agurlask/chipathon-2026-gf180mcu-hall-effect-sensor/docs/schematic_review/schematic_review.tex

\documentclass{article}

\usepackage[T1]{fontenc}
\usepackage{cite}
\usepackage{graphicx} 
\usepackage{caption}    
\usepackage{subcaption} 
\usepackage{booktabs}
\usepackage{array}
\usepackage{siunitx}
\usepackage{float}
\usepackage{tabularx}
\usepackage{indentfirst}
\usepackage{xcolor}
\usepackage{url}
\usepackage{amssymb}

\renewcommand{\arraystretch}{1.2}
\setlength{\tabcolsep}{6pt}

\title{Capacitively-Coupled Chopper Instrumentation Amplifier for Linear Hall Effect Sensor \\[1ex] \large IEEE SSCS Chipathon 2026}
\author{Team Chop}
\date{\today}

\begin{document}

\maketitle

\newpage

\tableofcontents

\newpage

\section{Project Information}

\begin{center}
\begin{tabular}{|c c|} 
 \hline
 Project Name & CCIA for Linear Hall Effect Sensor \\
 \hline
 Team Members & alang \\ 
 \hline
 Review Date &  \\
 \hline
 Review Version &  \\
 \hline
 Track & B \\
 \hline
\end{tabular}
\end{center}

\newpage

\section{Design Objective}

The aim of this project is to design and characterize a monolithic magnetic sensing system based on the Hall Effect. 
If tapeout is completed, the specifications of the sensor and readout circuit will be characterized individually.

The target specifications for the magnetic sensing system are shown in Table~\ref{tab:system_specs}. 
These are currently guess-timated based on what has been achieved in the literature 
and are subject to change.

\begin{table}[H]
    \centering
    \begin{tabular}{|c c|}
        \hline
        \textbf{Specification} & \textbf{Value} \\
        \hline
        Maximum Offset & \SI{100}{\micro\tesla} \\
        \hline
        Area & \SI{0.25}{\milli\meter\squared} \\
        \hline
        Resolution & \SI{100}{\micro\tesla}\textsubscript{rms} \\
        \hline
        Input Range & \SI{50}{\milli\tesla}\textsubscript{rms} \\
        \hline
        Bandwidth & \SI{10}{\kilo\hertz} \\
        \hline
        Supply Voltage ($V_{DD}$) & \SI{3.3}{\volt} \\
        \hline
        Maximum Supply Current & \SI{2}{\milli\ampere} \\
        \hline
        Operating Temperature & \SI{25}{\degreeCelsius} \\
        \hline
        Chopping Frequency & \SI{100}{\kilo\hertz} \\
        \hline
        Nominal Output Common-Mode Voltage & $V_{DD}$/2 \\
        \hline
    \end{tabular}
    \caption{System Specifications}
    \label{tab:system_specs}
\end{table}

The motivation for this project in the context of the Chipathon program is to provide reusable IP to the open-source silicon community.
Priority will be given to designing a simple system that can be well characterized as opposed to a novel system.
Overall, if the tapeout is successful, future designers would be able to reuse and customize both the sensor design and
the readout circuit for their specific application. In any case, future Chipathon participants will be able to learn from the 
successes and failures of the project. 

\newpage

\section{System Overview}

A block diagram of the system is shown in Fig.~\ref{fig:block_diagram}. 

\begin{figure}[htbp]
    \centering
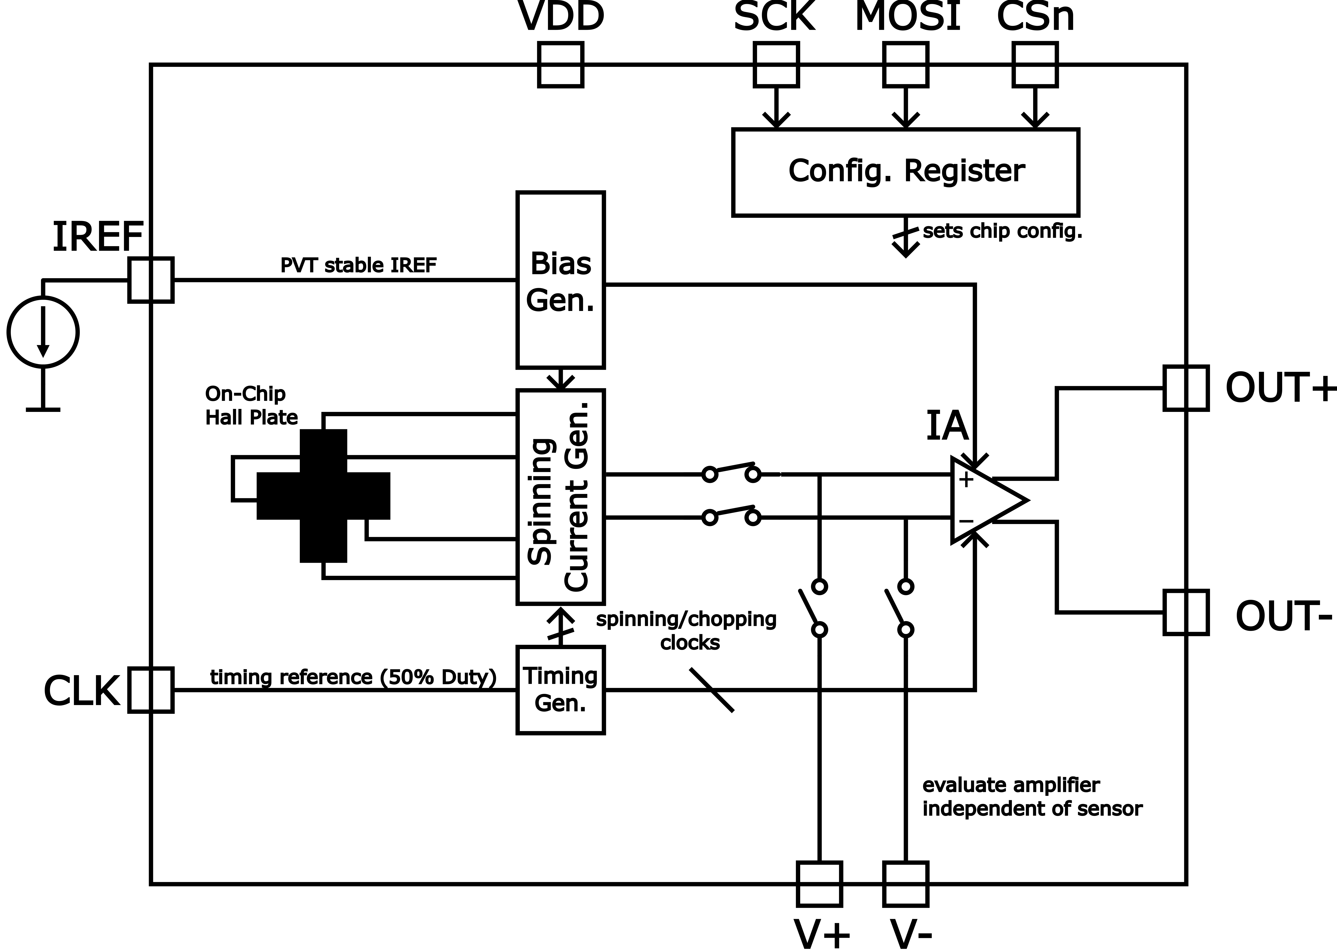
[picture p1: docs/schematic_review/figs/chip_block_diagram.png]
    
    \caption{Block diagram of the proposed architecture.}
    \label{fig:block_diagram}
\end{figure}

In the diagram, an on-chip horizontal Hall plate converts an incoming magnetic
field (perpendicular to plane of chip) into a small voltage that is amplified by the instrumentation amplifier (IA)
prior to being driven to the DUT output pins (OUT+/OUT-). The entire design operates from 
a single supply. Aside from the SPI configuration interface (only used during idle periods), 
the entire design operates in a single synchronous clock domain derived from the external clock signal (CLK).
Two additional pins are used as analog debug pins (V+/V-). Based on the system configuration, these pins will used
to probe various points within the design to enable individual characterization of the sensor and IA.

A full pinout table of the design is given in Table~\ref{tab:pinout}.

\begin{table}[H]
    \centering
    \begin{tabularx}{\linewidth}{l l X}
        \toprule

        \multicolumn{3}{l}{\textbf{Analog Pins}} \\
        \midrule
        IREF   & Analog & Current reference \\
        OUT+   & Analog & (+) Output \\
        OUT-   & Analog & (-) Output \\
        VTP+   & Analog & (+) Test Point \\
        VTP-   & Analog & (-) Test Point \\
        \midrule

        \multicolumn{3}{l}{\textbf{Digital Pins}} \\
        \midrule
        SCK    & Digital Input & SPI configuration clock \\
        MOSI   & Digital Input & SPI configuration data input \\
        CSn    & Digital Input & SPI chip select \\
        CLK    & Digital Input & Chopping/spinning clock reference \\
        \midrule

        \multicolumn{3}{l}{\textbf{Supply Pins}} \\
        \midrule
        VDD    & Power & Supply input \\
        VSS    & Power & Ground (shared with other Chipathon blocks) \\
        \bottomrule
    \end{tabularx}
    \caption{Project I/O description.}
    \label{tab:pinout}
\end{table}

\newpage

\section{Schematic Summary}

\textbf{Note:} Only open \path{xschem} from the \path{xschem/} directory 
(i.e., \path{cd} to \path{xschem/} and then run \path{xschem} \path{/path/to/schematic} to open any schematics).

This section describes the schematic-level operation of each part of the design. For each block, 
both behavioral and transistor-level models are described, including motivation for key design 
decisions. For all blocks, the transistor-level sizing is subject to change during the verification
process.

A more detailed block diagram of the top level schematic is shown in Fig.~\ref{fig:top_level_bhv}, using 
the signal names used throughout the Xschem schematic design. The sub-sections below describe the detailed operation
of each block.

\begin{figure}[htbp]
    \centering
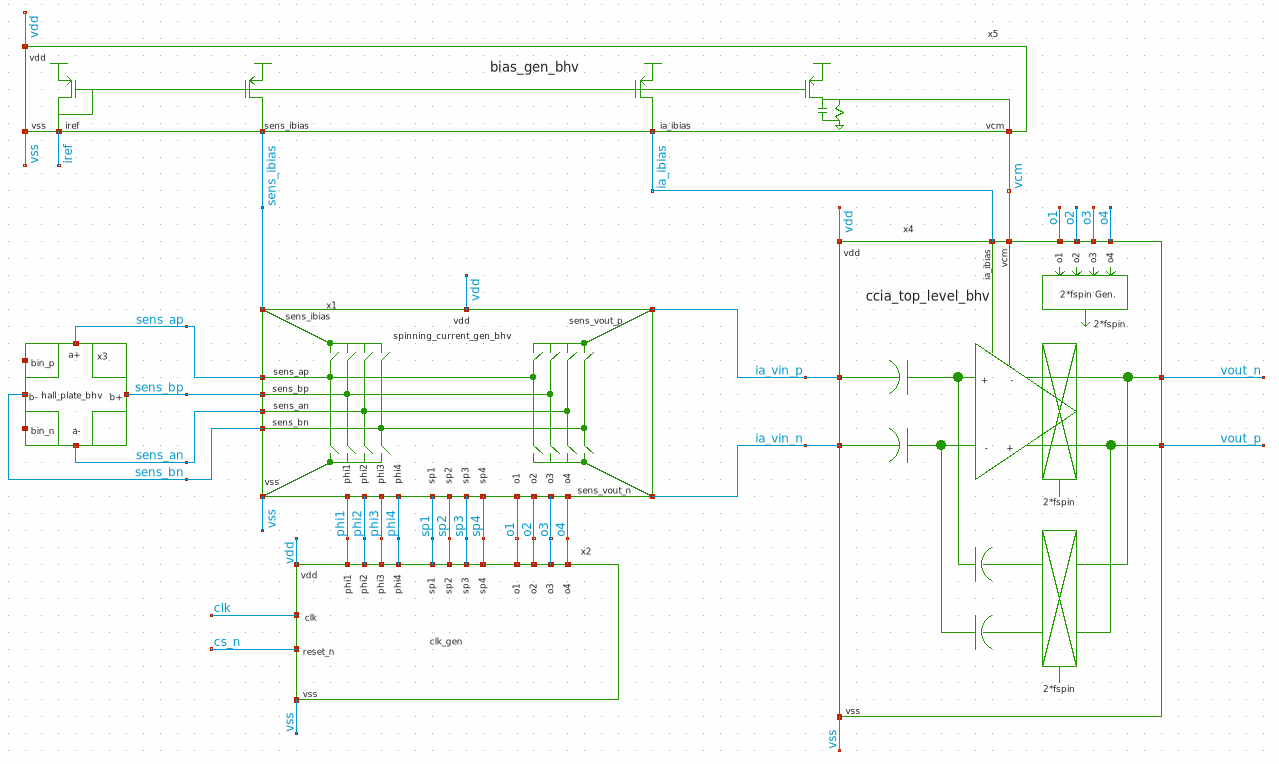
[picture p2: docs/schematic_review/figs/top_level_bhv.png]
    
    \caption{
        More detailed block diagram of top level schematic, showing the detailed connection 
        between all blocks, excluding the SPI configuration interface. 
        The Hall plate (left) is connected to the spinning current generator (center),
        which periodically swaps the bias/readout terminals of the sensor prior to
        amplification and demodulation by the instrumentation amplifier (right). The internal 
        clocks are generated by the clock generator block (bottom) and all bias currents
        are derived from an external reference in the bias generator block (top).
    }
    \label{fig:top_level_bhv}
\end{figure}

\subsection{On-Chip Hall Plate}

\subsubsection*{Purpose}

The on-chip Hall plate is a four-terminal device. Throughout the design,
the naming convention given in \cite{Mosser2017SpinningCurrent} is used to refer to the four terminal device. The orientation
of the four pins, (a+, b+, a-, b-), is shown in Fig.~\ref{fig:hall_plate_bhv}. As hinted
in the schematic symbol, a cross-shaped plate geometry is used to enable
four-phase spinning current operation, described in Section~\ref{subsec:spinning_current_generation}.

\begin{figure}[htbp]
    \centering
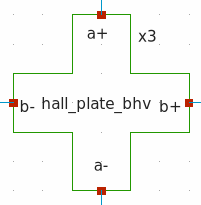
[picture p3: docs/schematic_review/figs/hall_plate_bhv.png]
    
    \caption{
        Xschem schematic symbol for on-chip Hall plate, showing (a+, b+, a-, b-) pin
        orientation and naming convention.
    }
    \label{fig:hall_plate_bhv}
\end{figure}

\subsubsection*{Inputs and Outputs}

As discussed in the previous section, the Hall plate has only four terminals since the
bias and readout is performed in a higher-level block.

INSERT I/O TABLE

\subsubsection*{Sub-sheets}

\begin{itemize}
    \item{Behavioral: \path{xschem/hall_plate_bhv/hall_plate_bhv.sch}}
    \item{Implementation: \textcolor{red}{$\times$}}
\end{itemize}

\subsubsection*{Behavioral Model}

The plan for sensor behavioral modeling is to use the basic model linear model 
described in \cite{Xu2011ImprovedEquivalent}. Clearly, the symbol shown in Fig.~\ref{fig:hall_plate_bhv} needs an
additional input to provide the incoming magnetic field.

\subsubsection*{Design Methodology}

\begin{itemize}
    \item{n-well used to maximize sensitivity}
    \item{
        Design equations in \cite{Xu2011ImprovedEquivalent} used to estimate bridge resistor values 
        in behavioral model from n-well sheet resistance, n-well electron mobility, and geometry
    }
    \begin{itemize}
        \item{
            Sensor geometry target currently 75x75 um (from \cite{Xu2011ImprovedEquivalent}, L=25 um and W=25 um).
            Final decision will depend on (1) min contact size/DRC limitations, (2) parasitic capacitance, 
            (3) thermal considerations at maximum bias current.
        }
        \item{n-well electron mobility estimated to make sensor have raw sensitivity of $\SI{100}{\volt\per(\ampere\cdot\tesla)}$}
    \end{itemize}
\end{itemize}

\subsubsection*{Transistor-Level Implementation}

The final schematic for Hall-Plate will simply have pins for the four terminals for
DRC/LVS purposes. All verification will be performed with the behavioral model so that 
the effect of an external magnetic field can be simulated.

\subsection{Bias Generation}

\subsubsection*{Purpose}

The purpose of the bias generation block is to produce the bias currents and voltages needed
by each block from an off-chip reference current. A conceptual schematic of the bias generation block
is shown in Fig.~\ref{fig:bias_gen_bhv}.

\begin{figure}[htbp]
    \centering
    
    \caption{
        Xschem schematic symbol for bias generation block.
        The block creates the sensor bias current and IA current reference from
        an off-chip reference current source. Also, the IA common-mode voltage is generated 
        by an on-chip R-C (buffer may be added if load large enough).  
    }
    \label{fig:bias_gen_bhv}
\end{figure}

\subsubsection*{Inputs and Outputs}

INSERT I/O TABLE

\subsubsection*{Sub-sheets}

\begin{itemize}
    \item{Behavioral: \textcolor{red}{$\times$}}
    \item{Implementation: \textcolor{red}{$\times$}}
\end{itemize}

\subsubsection*{Behavioral Model}

Due to the relative simplicity of the design and issues with ideal current sources
with zero load (large voltage spikes), no behavioral modeling will be done for this block.

\subsubsection*{Design Methodology}

As hinted in the schematic symbol, current mirrors will be used to produce
the bias currents. Transistor dimensions will be chosen to minimize short-channel
effects and current mismatch.

The common-mode voltage generator will be evaluated initially to do the required I-V conversion.

\subsubsection*{Transistor-Level Implementation}

Not started: \textcolor{red}{$\times$}

\subsection{Spinning Current Generation}
\label{subsec:spinning_current_generation}

\subsubsection*{Purpose}

The purpose of the spinning current generation block is to periodically switch the roles
of the four sensor terminals between BIAS+, BIAS-, SENSE+, and SENSE-. The switching sequence is chosen to separate the hall voltage from
the sensor offset and 1/f noise (the hall voltage is modulated to high frequency while the offset and 1/f noise
remains at DC). This allows the sensor offset and 1/f noise to be largely removed from the hall voltage 
in later processing stages. 

A conceptual schematic diagram of the spinning current generation block is shown 
in Fig.~\ref{fig:spinning_current_gen_bhv}. The naming convention for spinning clocks
is stolen from \cite{Jiang2019CMOSWideBandwidth}, where \textit{sp(x)} clocks show the active phase, 
\textit{phi(x)} clocks are used to connect the sensor bias currents to the BIAS terminals,
and \textit{o(x)} clocks are used to connect the SENSE terminals to the IA input.
Separate clocks are used to connect the BIAS and SENSE terminals to avoid adding additional 
spikes to the IA input from the bias current switching 
(time is given for the SENSE voltage to settle prior to connection to the IA). 

\begin{figure}[htbp]
    \centering
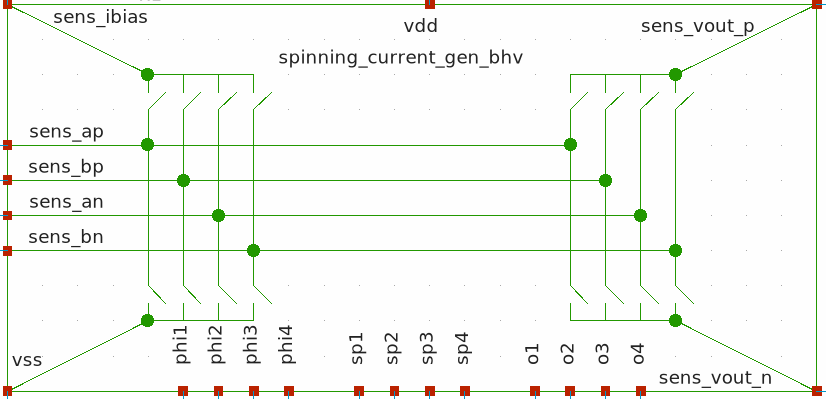
[picture p4: docs/schematic_review/figs/spinning_current_gen_bhv.png]
    
    \caption{
        Xschem schematic symbol for spinning current generation block.
    }
    \label{fig:spinning_current_gen_bhv}
\end{figure}

\subsubsection*{Inputs and Outputs}

INSERT I/O TABLE

\subsubsection*{Sub-sheets}

\begin{itemize}
    \item{Behavioral: \path{xschem/spinning_current_gen_bhv/spinning_current_gen_bhv.sch}}
    \item{Implementation: \textcolor{red}{$\times$}}
\end{itemize}

\subsubsection*{Behavioral Model}

Ideal switches will be used to implement the eight switches needed to connect
the sensor to the IA.

\subsubsection*{Design Methodology}

Transmission gates will be used to implement the SENSE and BIAS switches.
Consideration will be given to both on-resistance and charge injection (ADD REF).

\subsubsection*{Transistor-Level Implementation}

Not started: \textcolor{red}{$\times$}

\subsection{Timing Signal Generation}

\subsubsection*{Purpose}

The purpose of the timing signal generation block is to produce the \textit{sp(x)}, 
\textit{phi(x)}, and \textit{o(x)} clocks from an external clock. Descriptions of the 
three clock signals are given in Section~\ref{subsec:spinning_current_generation}.
The external interface of the timing signal generation block is shown in Fig.~\ref{fig:clk_gen_bhv} 

\begin{figure}[htbp]
    \centering
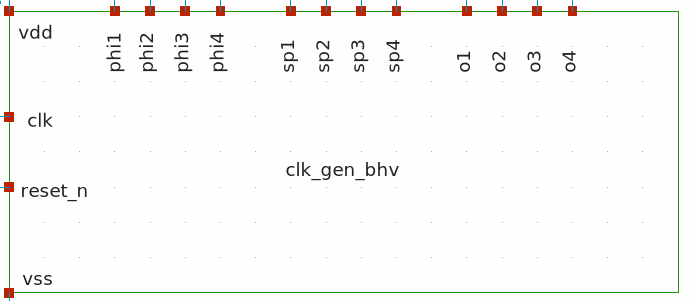
[picture p5: docs/schematic_review/figs/clk_gen_bhv.png]
    
    \caption{
        Xschem schematic symbol for timing signal generation block.
    }
    \label{fig:clk_gen_bhv}
\end{figure}

\subsubsection*{Inputs and Outputs}

INSERT I/O TABLE

\subsubsection*{Sub-sheets}

\begin{itemize}
    \item{Behavioral: \textcolor{red}{$\times$} (see below)}
    \item{Implementation: \path{xschem/clk_gen/clk_gen.sch}}
\end{itemize}

\subsubsection*{Behavioral Model}

Standard cells are directly used to implement the clock generation 
logic. If this slows down simulation significantly, time will be invested to 
use the ngspice XSPICE primitives to implement the required digital circuit in 
an event-driven paradigm. Since I could not find symbols for the GF180MCU 7T standard cells,
custom symbols were created (\path{xschem/mcu7t5v0/})

\subsubsection*{Design Methodology}

The clock generation circuits from Chapter 3 of \cite{Jiang2019CMOSWideBandwidth} will be used. 

\subsubsection*{Transistor-Level Implementation}

Completed: \textcolor{green}{\checkmark}

\subsection{Configuration Register}

The configuration register will be a N-bit shift register, allowing for the dynamic
configuration of the test chip. Some ideas of configuration options are: (1) variable sensor
bias current, (2) preamplifier voltage input (i.e., disconnect sensor and supply IA input externally),
(3) sensor debug (i.e., connect hall plate terminals to external pins for debug). 
Once more of the implementation is completed, these configuration options will be revisited.

\subsection{Instrumentation Amplifier}

The IA will use a CCIA structure very similar to the one reported in \cite{Zou2023CMOSHallArray}.

\begin{itemize}
    \item{Purpose}
    \item{Inputs and Outputs}
    \item{Sub-sheets}
    \item{Behavioral Model}
    \item{Design Methodology}
    \item{Transistor-Level Implementation}
\end{itemize}

\newpage

\section{Design Assumptions}

The following assumptions are made within the design.

\begin{itemize}
    \item{The circuit shall be designed to operate from a single 3.3V supply}
    \item{The circuit shall be designed to operate over the temperature range of (\SI{-40}{\degreeCelsius} - \SI{125}{\degreeCelsius}). 
    Accurately modeling the sensor over this temperature range is out of scope, so system specifications are only given at room temperature.}
    \item{The specifications of each circuit shall be simulated over all worst-case process corners}
    \item{Each analog output (both OUT+ and OUT-) of the 
    readout circuit shall be capable of driving a 
    10 pF off-chip load (representative of commericially available 
    CMOS op amps).}
    \item{
    To test the full system, an external magnetic 
    field will be applied via a Helmholtz coil pair. 
    A printed circuit board will be designed to supply 
    all DUT inputs and condition the differential 
    readout circuit output prior to digitization.
    }
\end{itemize}

\newpage

\section{Verification Status}

\subsection{Functional Simulations}

\subsubsection*{Basic Spinning Current Verification}

The purpose of this testbench is to verify the sensor behavioral model and spinning current generation
appropriately reduce the sensor offset using ideal IA and chopping switches. 

See \path{/xschem/spin_test/spin_test.sch}

\subsection{Corner Simulations}

Not started

\subsection{Monte Carlo}

Not started

\subsection{Sign-off}

\begin{itemize}
    \item{ERC Status \textcolor{red}{$\times$}}
    \item{DRC Status \textcolor{red}{$\times$}}
    \item{LVS Status \textcolor{red}{$\times$}}
\end{itemize}

\newpage

\section{Design Checklist}

\subsection{Functionality}

\begin{itemize}
    \item{Requirements implemented \textcolor{red}{$\times$}}
    \item{Reset behavior verified \textcolor{red}{$\times$}}
    \item{Startup verified \textcolor{red}{$\times$}}
    \item{Power sequencing considered \textcolor{red}{$\times$}}
\end{itemize}

\subsection{Analog}

\begin{itemize}
    \item{Bias currents checked \textcolor{red}{$\times$}}
    \item{Device operating regions verified \textcolor{red}{$\times$}}
    \item{Stability analyzed \textcolor{red}{$\times$}}
    \item{Noise considered \textcolor{red}{$\times$}}
    \item{Matching requirements identified \textcolor{red}{$\times$}}
\end{itemize}

\subsection{Digital}

N/A

\subsection{Mixed-Signal}

N/A

\subsection{Reliability}

\begin{itemize}
    \item{Device voltage limits checked \textcolor{red}{$\times$}}
    \item{Current density reviewed \textcolor{red}{$\times$}}
    \item{Latch-up prevention considered \textcolor{red}{$\times$}}
    \item{ESD strategy identified \textcolor{red}{$\times$}}
\end{itemize}

\subsection{Documentation}

\begin{itemize}
    \item{Nets clearly named \textcolor{red}{$\times$}}
    \item{Hierarchy consistent \textcolor{red}{$\times$}}
    \item{Parameters documented \textcolor{red}{$\times$}}
    \item{Symbols match implementation \textcolor{red}{$\times$}}
\end{itemize}

\newpage

\section{Open Issues}

List of open issues with:

\begin{itemize}
    \item{Description}
    \item{Impact}
    \item{Proposed Solution}
    \item{Owner}
\end{itemize}

\newpage

\section{Questions for Reviewers}

\newpage

\section{Review Outcome}

\newpage

\section{Appendix}

\newpage

\cleardoublepage
\addcontentsline{toc}{section}{References}
\bibliographystyle{IEEEtran}
\bibliography{references}

\end{document}
