agurlask/chipathon-2026-gf180mcu-hall-effect-sensor/docs/schematic_review/schematic_review.pdf

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

## 2 Design Objective

The aim of this project is to design and characterize a monolithic magnetic sensing system based on the Hall Eect. If tapeout is completed, the specications of the sensor and readout circuit will be characterized individually.
The target specications for the magnetic sensing system are shown in Table 1. These are currently guess-timated based on what has been achieved in the literature and are subject to change.
Specication | Value
Maximum Oset | 100 µT
Area | 0.25 mm²
Resolution | 100 µTrms
Input Range | 50 mTrms
Bandwidth | 10 kHz
Supply Voltage (VDD) | 3.3 V
Maximum Supply Current | 2 mA
Operating Temperature | 25 ◦C
Chopping Frequency | 100 kHz
Nominal Output Common-Mode Voltage | VDD/2

Table 1: System Specications

The motivation for this project in the context of the Chipathon program is to provide reusable IP to the open-source silicon community. Priority will be given to designing a simple system that can be well characterized as opposed to a novel system. Overall, if the tapeout is successful, future designers would be able to reuse and customize both the sensor design and the readout circuit for their specic application. In any case, future Chipathon participants will be able to learn from the successes and failures of the project.

4

3 | System Overview
| A block diagram of the system is shown in Fig. 1.


Figure 1: Block diagram of the proposed architecture.

In the diagram, an on-chip horizontal Hall plate converts an incoming magnetic eld (perpendicular to plane of chip) into a small voltage that is amplied by the instrumentation amplier (IA) prior to being driven to the DUT output pins (OUT+/OUT-). The entire design operates from a single supply. Aside from the SPI conguration interface (only used during idle periods), the entire design operates in a single synchronous clock domain derived from the external clock signal (CLK). Two additional pins are used as analog debug pins (V+/V-). Based on the system conguration, these pins will used to probe various points within the design to enable individual characterization of the sensor and IA. A full pinout table of the design is given in Table 2.

5

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

4 | Schematic Summary
| Note: Only open xschem from the xschem/ directory (i.e., cd to xschem/
and then run xschem /path/to/schematic to open any schematics).
| This section describes the schematic-level operation of each part of the de-
sign. For each block, both behavioral and transistor-level models are described, including motivation for key design decisions. For all blocks, the transistor-level sizing is subject to change during the verication process.
| A more detailed block diagram of the top level schematic is shown in Fig. 2,
using the signal names used throughout the Xschem schematic design. The sub-sections below describe the detailed operation of each block.


Figure 2: More detailed block diagram of top level schematic, showing the detailed connection between all blocks, excluding the SPI conguration interface. The Hall plate (left) is connected to the spinning current generator (center), which periodically swaps the bias/readout terminals of the sensor prior to amplication and demodulation by the instrumentation amplier (right). The internal clocks are generated by the clock generator block (bottom) and all bias currents are derived from an external reference in the bias generator block (top).

4.1 On-Chip Hall Plate

Purpose

The on-chip Hall plate is a four-terminal device. Throughout the design, the naming convention given in [1] is used to refer to the four terminal device. The orientation of the four pins, (a+, b+, a-, b-), is shown in Fig. 3. As hinted in the

7

schematic symbol, a cross-shaped plate geometry is used to enable four-phase spinning current operation, described in Section 4.3.

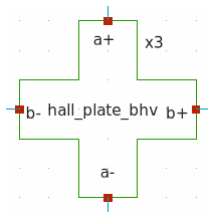
[picture p7: figure]

Figure 3: Xschem schematic symbol for on-chip Hall plate, showing (a+, b+, a-, b-) pin orientation and naming convention.

Inputs and Outputs

As discussed in the previous section, the Hall plate has only four terminals since the bias and readout is performed in a higher-level block.
INSERT I/O TABLE

Sub-sheets

Behavioral: xschem/hall_plate_bhv/hall_plate_bhv.sch

Implementation: ×

Behavioral Model

The plan for sensor behavioral modeling is to use the basic model linear model described in [2]. Clearly, the symbol shown in Fig. 3 needs an additional input to provide the incoming magnetic eld.

Design Methodology

n-well used to maximize sensitivity

Design equations in [2] used to estimate bridge resistor values in behavioral model from n-well sheet resistance, n-well electron mobility, and geometry

Sensor geometry target currently 75x75 um (from [2], L=25 um and W=25 um). Final decision will depend on (1) min contact size/DRC limitations, (2) parasitic capacitance, (3) thermal considerations at maximum bias current.
n-well electron mobility estimated to make sensor have raw sensitivity of 100 V/(A · T)

8

Transistor-Level Implementation

The nal schematic for Hall-Plate will simply have pins for the four terminals for DRC/LVS purposes. All verication will be performed with the behavioral model so that the eect of an external magnetic eld can be simulated.

4.2 Bias Generation

Purpose

The purpose of the bias generation block is to produce the bias currents and voltages needed by each block from an o-chip reference current. A conceptual schematic of the bias generation block is shown in Fig. 4.

Figure 4: Xschem schematic symbol for bias generation block. The block creates the sensor bias current and IA current reference from an o-chip reference current source. Also, the IA common-mode voltage is generated by an on-chip R-C (buer may be added if load large enough).

Inputs and Outputs

INSERT I/O TABLE

Sub-sheets

Behavioral: ×

Implementation: ×

Behavioral Model

Due to the relative simplicity of the design and issues with ideal current sources with zero load (large voltage spikes), no behavioral modeling will be done for this block.

Design Methodology

As hinted in the schematic symbol, current mirrors will be used to produce the bias currents. Transistor dimensions will be chosen to minimize shortchannel eects and current mismatch.
The common-mode voltage generator will be evaluated initially to do the required I-V conversion.

9

Transistor-Level Implementation

Not started: ×

4.3 Spinning Current Generation

Purpose

The purpose of the spinning current generation block is to periodically switch the roles of the four sensor terminals between BIAS+, BIAS-, SENSE+, and SENSE-. The switching sequence is chosen to separate the hall voltage from the sensor oset and 1/f noise (the hall voltage is modulated to high frequency while the oset and 1/f noise remains at DC). This allows the sensor oset and 1/f noise to be largely removed from the hall voltage in later processing stages. A conceptual schematic diagram of the spinning current generation block is shown in Fig. 5. The naming convention for spinning clocks is stolen from [3], where sp(x) clocks show the active phase, phi(x) clocks are used to connect the sensor bias currents to the BIAS terminals, and o(x) clocks are used to connect the SENSE terminals to the IA input. Separate clocks are used to connect the BIAS and SENSE terminals to avoid adding additional spikes to the IA input from the bias current switching (time is given for the SENSE voltage to settle prior to connection to the IA).


Figure 5: Xschem schematic symbol for spinning current generation block.

Inputs and Outputs

INSERT I/O TABLE

10

Sub-sheets

Behavioral: xschem/spinning_current_gen_bhv/spinning_current_gen_ bhv.sch

Implementation: ×

Behavioral Model

Ideal switches will be used to implement the eight switches needed to connect the sensor to the IA.

Design Methodology

Transmission gates will be used to implement the SENSE and BIAS switches. Consideration will be given to both on-resistance and charge injection (ADD REF).

Transistor-Level Implementation

Not started: ×

4.4 Timing Signal Generation

Purpose

The purpose of the timing signal generation block is to produce the sp(x), phi(x), and o(x) clocks from an external clock. Descriptions of the three clock signals are given in Section 4.3. The external interface of the timing signal generation block is shown in Fig. 6


Figure 6: Xschem schematic symbol for timing signal generation block.

11

Inputs and Outputs

INSERT I/O TABLE

Sub-sheets

Behavioral: × (see below)

Implementation: xschem/clk_gen/clk_gen.sch

Behavioral Model

Standard cells are directly used to implement the clock generation logic. If this slows down simulation signicantly, time will be invested to use the ngspice XSPICE primitives to implement the required digital circuit in an event-driven paradigm. Since I could not nd symbols for the GF180MCU 7T standard cells, custom symbols were created (xschem/mcu7t5v0/)

Design Methodology

The clock generation circuits from Chapter 3 of [3] will be used.

Transistor-Level Implementation

Completed: ✓

4.5 Conguration Register

The conguration register will be a N-bit shift register, allowing for the dynamic conguration of the test chip. Some ideas of conguration options are:
(1) variable sensor bias current, (2) preamplier voltage input (i.e., disconnect sensor and supply IA input externally), (3) sensor debug (i.e., connect hall plate terminals to external pins for debug). Once more of the implementation is completed, these conguration options will be revisited.

4.6 Instrumentation Amplier

The IA will use a CCIA structure very similar to the one reported in [4].

Purpose

Inputs and Outputs

Sub-sheets

Behavioral Model

Design Methodology

Transistor-Level Implementation

12

5 | Design Assumptions
| The following assumptions are made within the design.
| The circuit shall be designed to operate from a single 3.3V supply The circuit shall be designed to operate over the temperature range of (−40 ◦C - 125 ◦C). Accurately modeling the sensor over this temperature range is out of scope, so system specications are only given at room temperature. The specications of each circuit shall be simulated over all worst-case process corners Each analog output (both OUT+ and OUT-) of the readout circuit shall be capable of driving a 10 pF o-chip load (representative of commericially available CMOS op amps). To test the full system, an external magnetic eld will be applied via a Helmholtz coil pair. A printed circuit board will be designed to supply all DUT inputs and condition the dierential readout circuit output prior to digitization.

13

6 | Verication Status
6.1 | Functional Simulations

Basic Spinning Current Verication

The purpose of this testbench is to verify the sensor behavioral model and spinning current generation appropriately reduce the sensor oset using ideal IA and chopping switches.
See /xschem/spin_test/spin_test.sch

6.2 Corner Simulations

Not started

6.3 Monte Carlo

Not started

6.4 Sign-o

ERC Status ×

DRC Status ×

LVS Status ×

14

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

## References

[1] V. Mosser, N. Matringe, and Y. Haddab, A spinning current circuit for hall measurements down to the nanotesla range, IEEE Transactions on Instrumentation and Measurement, vol. 66, no. 4, pp. 637650, 2017. [Online]. Available: https://ieeexplore.ieee.org/document/7845584
[2] Y. Xu and H.-B. Pan, An improved equivalent simulation model for cmos integrated hall plates, Sensors, vol. 11, no. 6, pp. 62846296, 2011. [Online]. Available: https://www.mdpi.com/1424-8220/11/6/6284
[3] J. Jiang, Cmos wide-bandwidth magnetic sensors for contactless current measurements, Ph.D. dissertation, Delft University of Technology, 2019. [Online]. Available: https://doi.org/10.4233/uuid: 38dfa450-82c2-4b63-92d1-26b2eb3adeed
[4] H. Zou, K.-M. Lei, R. P. Martins, and P.-I. Mak, A cmos hall sensors array with integrated readout circuit resilient to local magnetic interference from current-carrying traces, IEEE Sensors Journal, vol. 23, pp. 16 14516 153, 2023. [Online]. Available: https://ieeexplore.ieee.org/document/10147816

20
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
