agurlask/chipathon-2026-gf180mcu-hall-effect-sensor/xschem/spin_test/diff_avg_plot.png

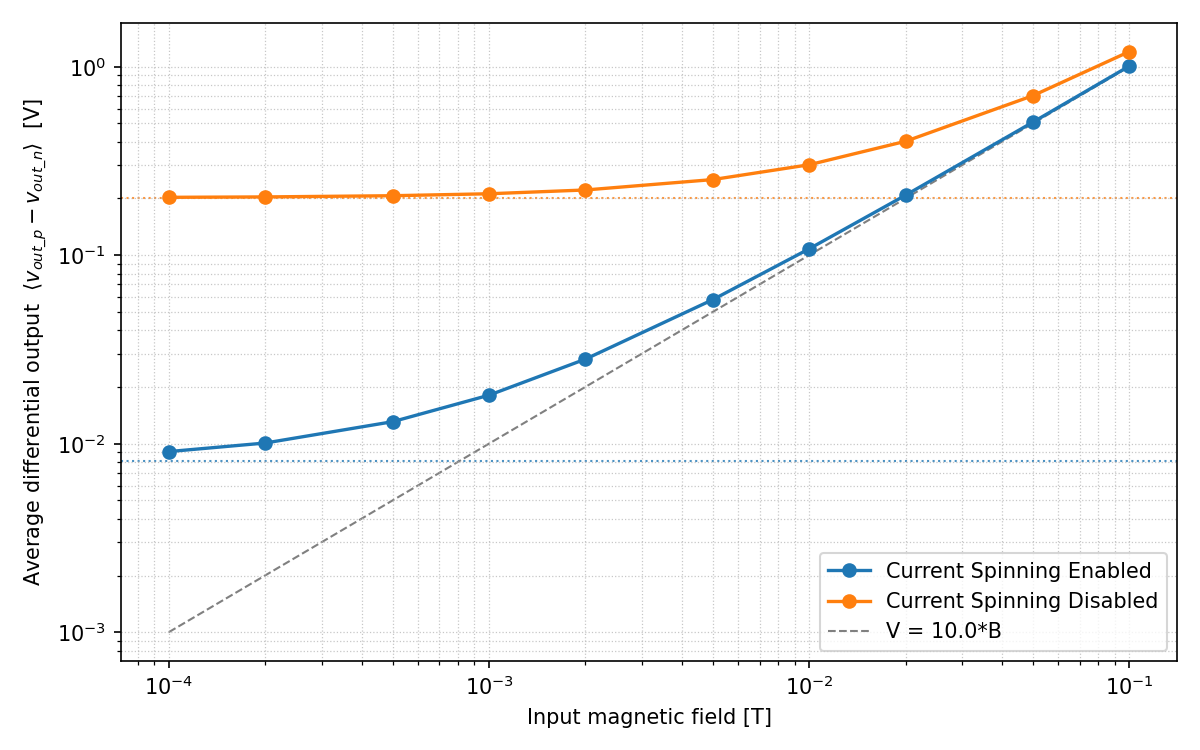
xschem/spin_test/diff_avg_plot.png
