agurlask/chipathon-2026-gf180mcu-hall-effect-sensor/xschem/spin_test/waveforms_plot.png

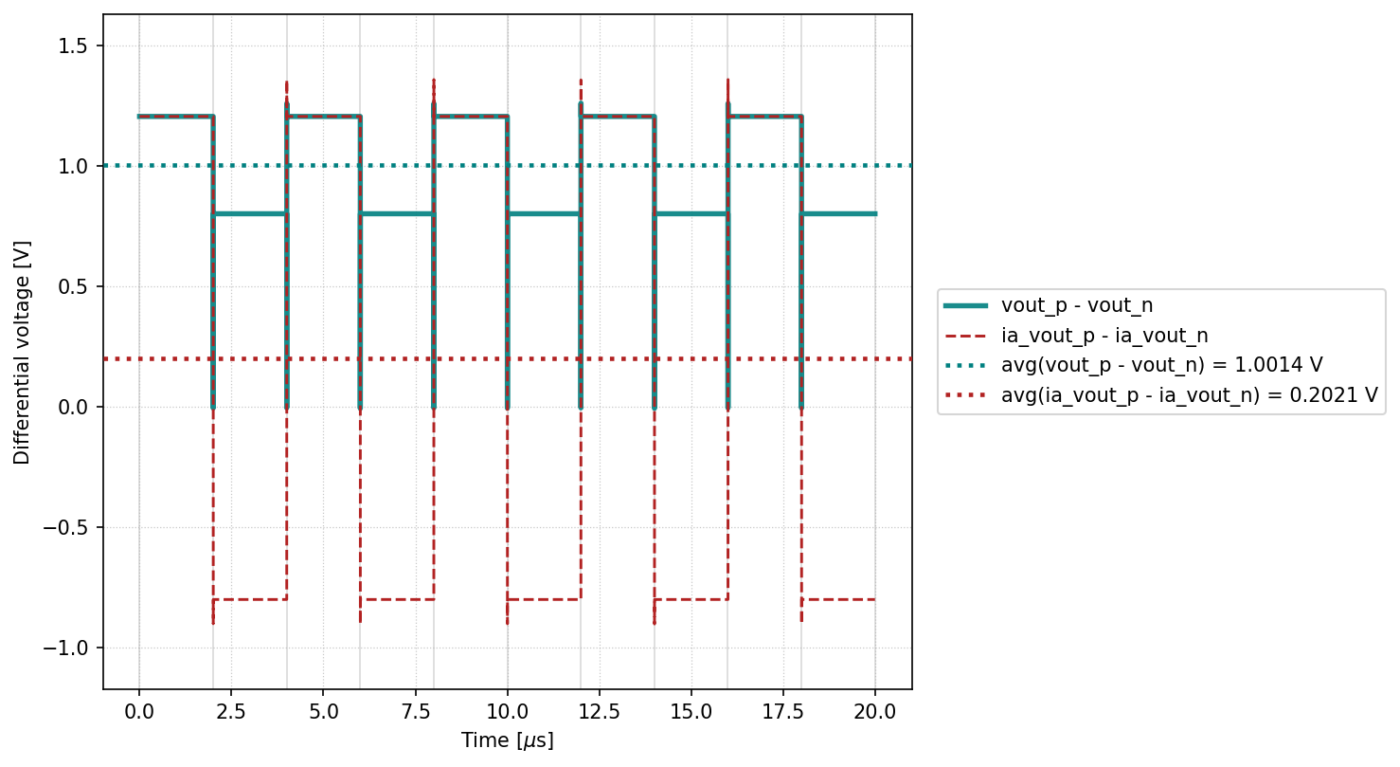
xschem/spin_test/waveforms_plot.png
