agurlask/chipathon-2026-gf180mcu-hall-effect-sensor/(commit log)

2026-06-13 Add pin table
2026-06-27 Reformat schematic review structure based on provided template
2026-06-28 Update schematic review doc
2026-06-28 Add updates to schematic review document
2026-06-30 Add behavioral pins
    [bias_gen_bhv.sch, ccia_top_level_bhv.sch, clkgen_bhv.sch, hall_plate_bhv.sch, spinning_current_gen_bhv.sch, top_level_bhv.sch]
2026-06-30 Add symbols for behavioral componenets
    [clkgen_bhv.sch, top_level_bhv.sch]
2026-07-01 Update behavioral models
    [ccia_top_level_bhv.sch, chopper_bhv.sch, chopper_ideal.sch, clk_gen_bhv.sch, ota_2stage_test.sch, ota_bhv.sch, ota_ideal.sch, top_level_bhv.sch]
2026-07-01 Update schematic review document
2026-07-01 Add references to schematic review document
2026-07-02 Add basic hall plate model and testbench
    [hall_plate_bhv.sch, hall_plate_bhv_tb.sch]
2026-07-02 Add spinning current test simulation
    [ccia_top_level_bhv.sch, chopper_bhv.sch, clk_gen.sch, clk_gen_bhv.sch, clk_gen_tb.sch, clk_gen_test.sch, gf180mcu_fd_sc_mcu7t5v0__dffrnq_1_test.sch, hall_plate_bhv.sch]
2026-07-04 Pre-recording updates
    [diff_avg_results.txt, hall_plate_bhv.sch, spin_test.sch]
2026-07-05 Update design document
    [diff_avg_results.txt, spin_test.sch]
2026-07-06 Add initial chopper implementation, tgate sizes chosen to match charge injection/clock feedthrough - not Ron
    [chopper.sch, chopper_tb.sch, tgate.sch, tgate_tb.sch]
2026-07-06 Add basic CCIA experiment to observe chopper errors related to charge injection/clock feedthrough, output ripple from offset
    [ccia_basic_experiment.sch, chopper_tb.sch, tgate.sch]
2026-07-07 Add initial folded cascode stage with new bias scheme
    [folded_cascode_test.sch, ota.sch]
2026-07-07 Remove output files and add noise sim
    [folded_cascode_test.sch]
2026-07-09 Add initial OTA design with bias verification
    [folded_cascode_test.sch, ota.sch, ota_tb.sch, s1_cmfb.sch, s1_input_pair.sch, s1_nmos_bias.sch, s1_nmos_casc.sch, s1_pmos_bias.sch]
2026-07-09 Update OTA sim results
    [ota_tb.sch]
2026-07-11 Add initial transistor-level CCIA simulation
    [ccia_main_ota.sch, ccia_top_level.sch, ota_cmfb_transient.sch, ota_tb.sch, s2_half_circuit.sch]
2026-07-13 Add initial telescopic amp prototype for continuous time RRL
    [telescopic_test.sch]
2026-07-13 Add initial telescopic schematics/symbols/bias check
    [telescopic.sch, telescopic_cascode.sch, telescopic_cascode_bias.sch, telescopic_cmfb.sch, telescopic_input_pair.sch, telescopic_pmos_bias.sch, telescopic_tb.sch, telescopic_test.sch]
2026-07-14 Add initial successful RRL simulation!
    [ccia_top_level.sch, telescopic_no_cmfb.sch]
2026-07-14 Add pseudoresistor implementation
    [ccia_top_level.sch, pseudores.sch, pseudores_test.sch, telescopic.sch, telescopic_input_pair.sch, telescopic_tb.sch]
